ichisaur/cableBot/1-15 meeting notes.md

# Team Roles

## Team Leader
Yichen

## Treasurer
Alex

## Electrical
Yichen <br>
Alex

## CAD
Lukai<br>
Jordan<br>
Alex

## Manufacturing
Alex <br>
Literally Everyone

## Software
Qinjie<br>
Jordan<br>
Lukai

## Algorithms
?????

# Goals for End of Quarter
Design for <br>
Motor controllers Driver Modules <br>
Microcontroller Circuitry
<br>External Case Design
<br>Control Algorithm Prototype
