ichisaur/cableBot/BYOM-Group1/MatlabAnalysis/Current-Torque.jpg

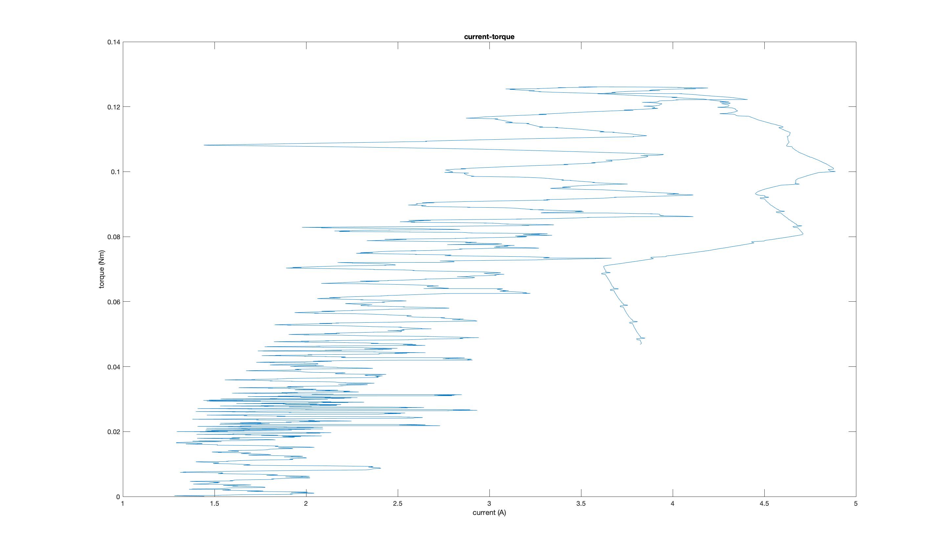
BYOM-Group1/MatlabAnalysis/Current-Torque.jpg
