ichisaur/cableBot/BYOM-Group1/MatlabAnalysis/Motor Current.jpg

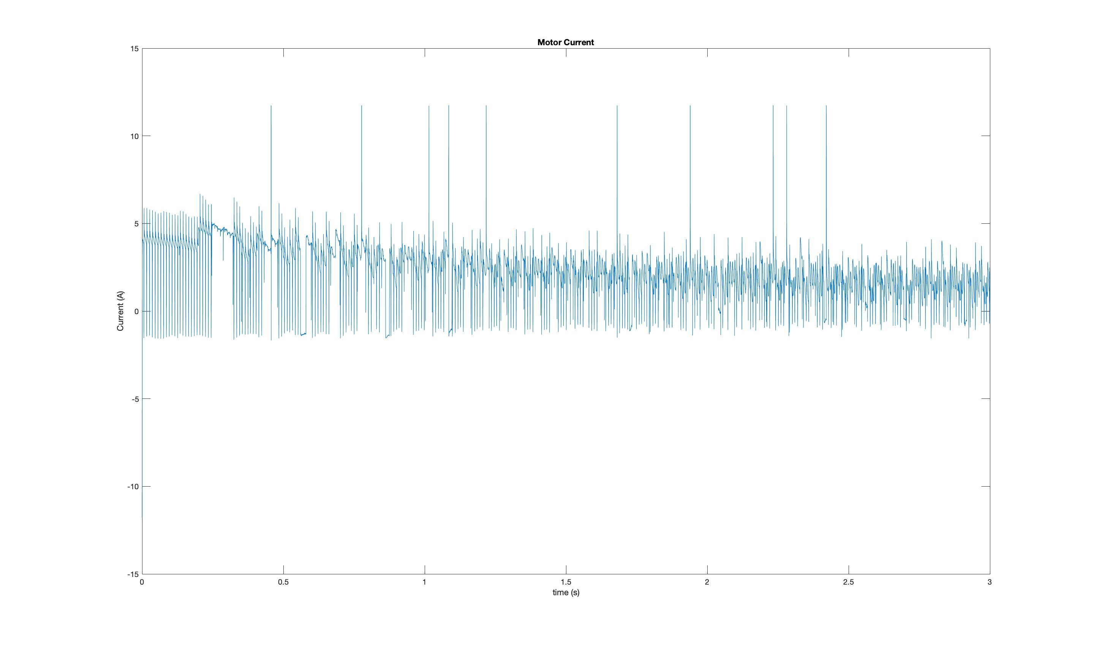
BYOM-Group1/MatlabAnalysis/Motor Current.jpg
