ichisaur/cableBot/BYOM-Group1/MatlabAnalysis/Motor Position.jpg

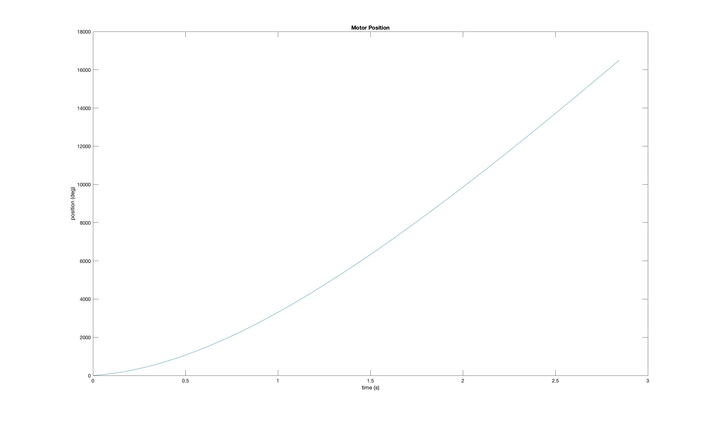
BYOM-Group1/MatlabAnalysis/Motor Position.jpg
