ichisaur/cableBot/BYOM-Group1/MatlabAnalysis/Motor speed.jpg

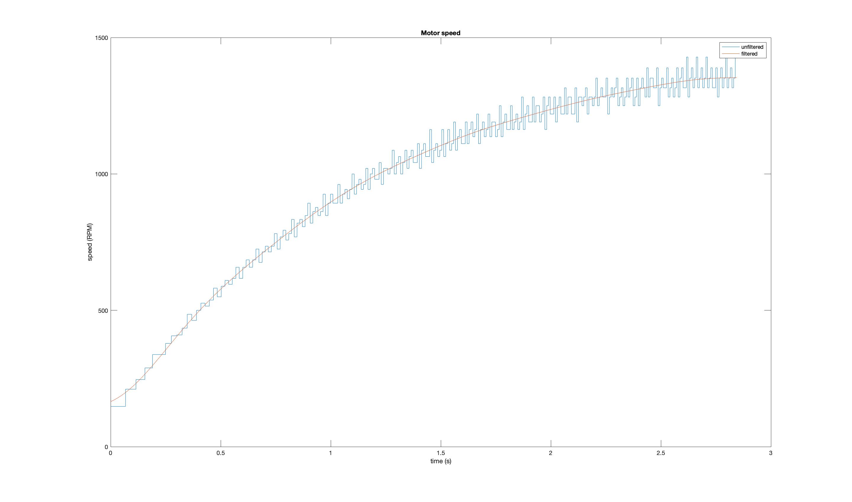
BYOM-Group1/MatlabAnalysis/Motor speed.jpg
