ichisaur/cableBot/BYOM-Group1/MatlabAnalysis/RMS Motor Current.jpg

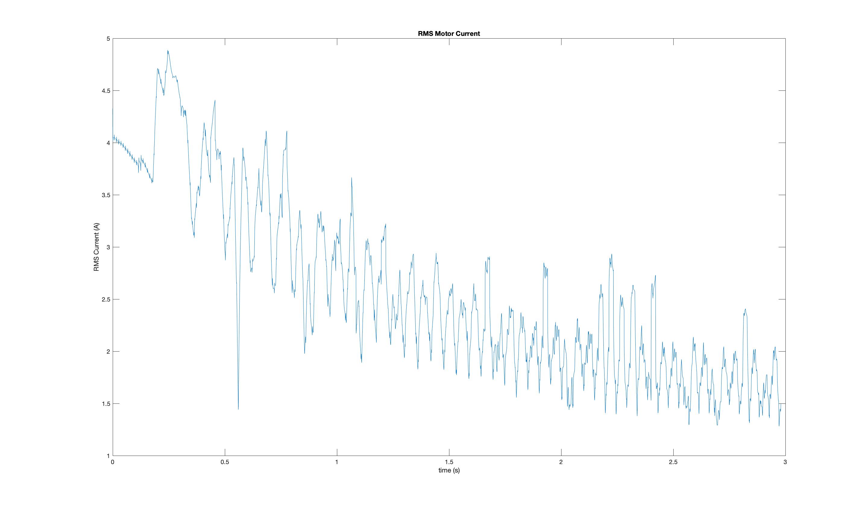
BYOM-Group1/MatlabAnalysis/RMS Motor Current.jpg
