ichisaur/cableBot/BYOM-Group1/MatlabAnalysis/Speed-Torque.jpg

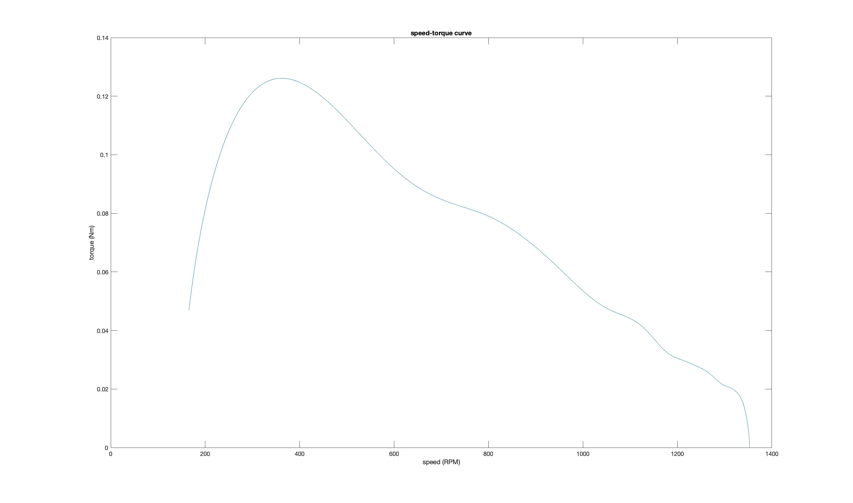
BYOM-Group1/MatlabAnalysis/Speed-Torque.jpg
