ichisaur/cableBot/Eagle Boards/Main Board/Electrical BOM.txt

Partlist exported from C:/Users/ichis/Documents/Development Area/cableBot/Eagle Boards/Main Board/main.sch at 3/15/2019 1:38 AM

Qty Value               Device              Package                  Parts                                                                                                                 Description                                                                                                      AVAILABILITY DESCRIPTION                                                                                  DIGI-KEY_PART_NUMBER DIGI-KEY_PURCHASE_URL                                                                                                                                                                    MANUFACTURER_PART_NUMBER MF      MP                  MPN     OC_FARNELL OC_NEWARK PACKAGE                         PRICE VENDOR                 
10  0.1uF               C-USC0805           C0805                    C5, C6, C7, C8, C9, C10, C11, C12, C13, C15                                                                           CAPACITOR, American symbol                                                                                                                                                                                                                                                                                                                                                                                                                                                                                                                                                              
25  10k                 R-US_R0603          R0603                    R1, R5, R6, R7, R8, R9, R10, R11, R12, R13, R14, R15, R16, R17, R18, R19, R20, R21, R22, R23, R24, R25, R26, R27, R28 RESISTOR, American symbol                                                                                                                                                                                                                                                                                                                                                                                                                                                                                                                                                               
2   10pF                C-USC0805           C0805                    C3, C4                                                                                                                CAPACITOR, American symbol                                                                                                                                                                                                                                                                                                                                                                                                                                                                                                                                                              
1   10uF                C-USC0805           C0805                    C14                                                                                                                   CAPACITOR, American symbol                                                                                                                                                                                                                                                                                                                                                                                                                                                                                                                                                              
4   1uF                 C-USC0805           C0805                    C16, C17, C18, C19                                                                                                    CAPACITOR, American symbol                                                                                                                                                                                                                                                                                                                                                                                                                                                                                                                                                              
2   24pF                C-USC0805           C0805                    C1, C2                                                                                                                CAPACITOR, American symbol                                                                                                                                                                                                                                                                                                                                                                                                                                                                                                                                                              
1   330                 R-US_R0805          R0805                    R2                                                                                                                    RESISTOR, American symbol                                                                                                                                                                                                                                                                                                                                                                                                                                                                                                                                                               
1   AB26TRB-32.768KHZ-T AB26TRB-32.768KHZ-T XTAL_AB26TRB-32.768KHZ-T XTAL1                                                                                                                 AB26TRB Series 32.768 kHz ±20 ppm 12.5 pF -40 to +85°C Cylindrical Watch Crystal                                               AB26TRB Series 32.768 kHz ±20 ppm 12.5 pF -40 to +85°C Cylindrical Watch Crystal            535-9033-1-ND        https://www.digikey.com/product-detail/en/abracon-llc/AB26TRB-32.768KHZ-T/535-9033-1-ND/675581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                                                       Abracon AB26TRB-32.768KHZ-T                              Cylindrical Can Radial  Abracon                              
1   ABM3-16.000MHZ-B2-T ABM3-16.000MHZ-B2-T XTAL500X320X130N         Y1                                                                                                                    Crystals 12MHz 18pF 30ppm -40C +85C                                                                                            Crystal 16MHz Ø·Â¢Ø¢Â±20ppm _Tol_ Ø·Â¢Ø¢Â±50ppm _Stability_ 18pF FUND 50Ohm 2-Pin CSMD T/R  535-9103-1-ND        https://www.digikey.com/product-detail/en/abracon-llc/ABM3-16.000MHZ-B2-T/535-9103-1-ND/675620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                                                       Abracon ABM3-16.000MHZ-B2-T                              SMD-2 Abracon                                                
12  BSS138SOT-23-3L-L   BSS138SOT-23-3L-L   SOT-23-3L-L              U3, U4, U5, U6, U7, U8, U9, U10, U11, U12, U13, U14                                                                   MOSFET, Level Shifting                                                                                                                                                                                                                                                                                                                                                                                                                                         BSS138                                                                                            Fairchild Semiconductor
1   FT232RL-TUBE        FT232RL-TUBE        SSOP28-LD                IC2                                                                                                                   USB to UART Chip                                                                                                                               USB-to-UART 1-CH 256byte FIFO 5V 28-Pin SSOP Tube                                           768-1306-ND          https://www.digikey.com/product-detail/en/ftdi-future-technology-devices-international-ltd/FT232RL-TUBE/768-1306-ND/4006920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                          FTDI,   FT232RL-TUBE                     SSOP-28 FTDI                                                 
1   Green               LEDCHIP-LED0805     CHIP-LED0805             LED1                                                                                                                  LED                                                                                                                                                                                                                                                                                                                                                                                                                                                                                                                                                                                     
1   JS202011SCQN        JS202011SCQN        SW_JS202011SCQN          S1                                                                                                                    JS Series DPDT On-On Gull Wing Surface Mount Subminiature Slide Switch                                           Unavailable   JS Series DPDT On-On Gull Wing Surface Mount Subminiature Slide Switch                                                                                                                                                                                                                                                             C&K     JS202011SCQN                                     None                            None                         
1   OMRON SWITCH        MOM_SWITCH          SWITCH                   B1                                                                                                                    Momentary Switch                                                                                                                                                                                                                                                                                                                                                                                                                                                                                                                                                                        
1   PROG                CONN_07             1X07                     J3                                                                                                                    Multi connection point. Often used as Generic Header-pin footprint for 0.1 inch spaced/style header connections                                                                                                                                                                                                                                                                                                                                                                                                                                                                         
1   PROG_RST            CONN_01             1X01                     J4                                                                                                                    Single connection point. Often used as Generic Header-pin footprint for 0.1 inch spaced/style header connections                                                                                                                                                                                                                                                                                                                                                                                                                                                                        
1   AZ1117EH-3.3        AZ1117EH-3.3        SOT223                   IC1                                                                                                                   800mA and 1A Low Dropout (LDO) Positive Regulator 3.3v                                                                                                                                                                                                                                                                                                                                                                                                                                                                                         
1   AZ1117EH-5.0        AZ1117EH-5.0        SOT223                   IC3                                                                                                                   800mA and 1A Low Dropout (LDO) Positive Regulator 5.0v                                                                                                                                                                                                                                                                                                                                                                                                                                                                                        
3   ST26C31BTR          ST26C31BTR          TSSOP16                  CR1, CR2, CR3                                                                                                                                                                                                                                                                                                                                                                                                                                                                                                                                                  ST26C31BTR                                                                                                              STMicroelectronics     
1   TM4C123GH6PMIPM64-L TM4C123GH6PMIPM64-L PM64-L                   U1                                                                                                                                                                                                                                                                                                                                                                                                                                                                                                                                                             TM4C123GH6PMI                                                                                                           Texas Instruments      
1   ZX62MICROUSB        ZX62MICROUSB        ZX62-AB-5PA(11)          U$1
