ichisaur/cableBot/Eagle Boards/Main Board/main.brd

## EAGLE design Eagle Boards/Main Board/main.brd (2019-05-23)

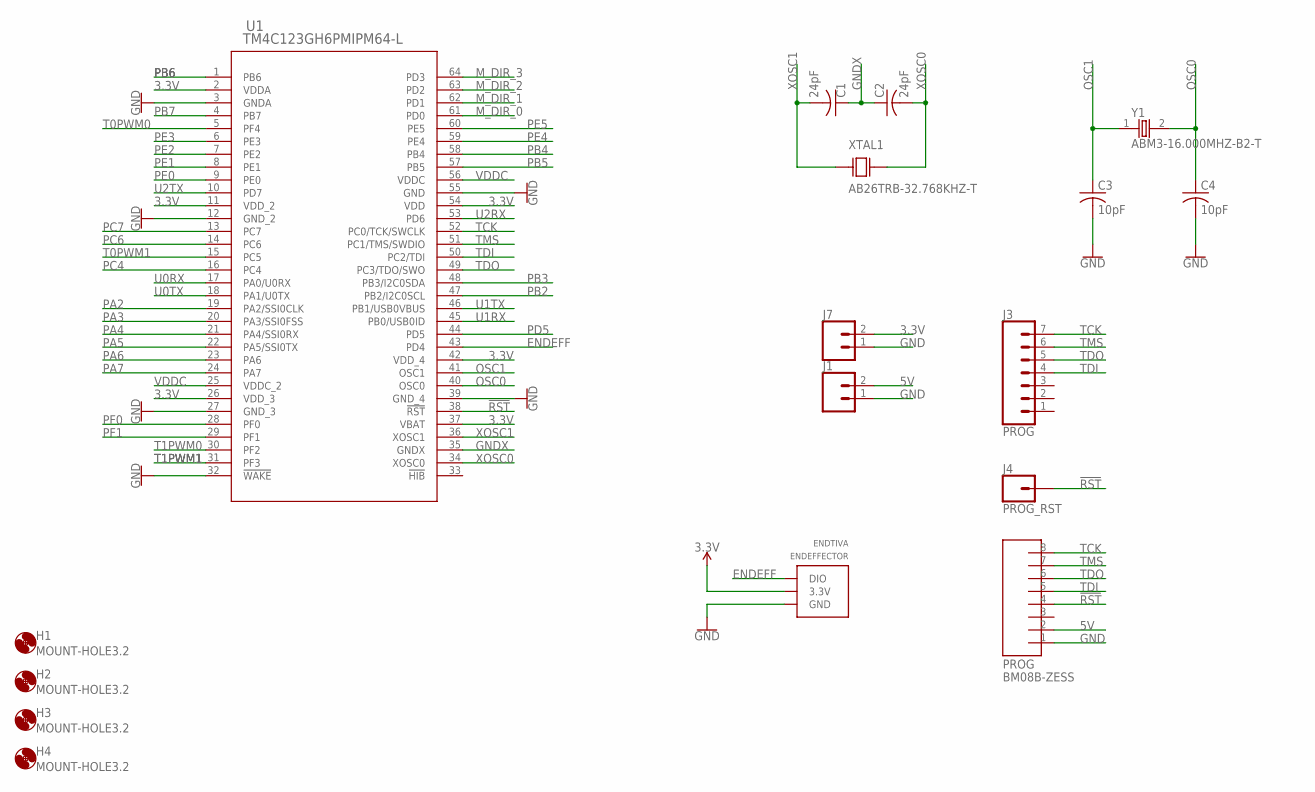
[picture p8: schematic main.sch, sheet 1, TIVA + IC]

Parts:
C1, C2: 24pF; C0805
C3, C4: 10pF; C0805
ENDEFFECTOR: ENDTIVA
H1, H2, H3, H4: MOUNT-HOLE3.2; 3,2
J1, J7: CONN_02; 1X02
J3: PROG; 1X07
J4: PROG_RST; 1X01
PROG: BM08B-ZESS
U1: TM4C123GH6PMIPM64-L; PM64-L
XTAL1: AB26TRB-32.768KHZ-T; XTAL_AB26TRB-32.768KHZ-T
Y1: ABM3-16.000MHZ-B2-T; XTAL500X320X130N

Connections:
3.3V: ENDEFFECTOR.3.3V, J7.2, U1.2 (VDDA), U1.11 (VDD_2), U1.26 (VDD_3), U1.37 (VBAT), U1.42 (VDD_4), U1.54 (VDD); also elsewhere on the board
5V: J1.2, PROG.2; also elsewhere on the board
!RST: J4.1, PROG.4, U1.38 (!RST); also elsewhere on the board
ENDEFF: ENDEFFECTOR.DIO, U1.43 (PD4)
GND: C3.2, C4.2, ENDEFFECTOR.GND, J1.1, J7.1, PROG.1, U1.3 (GNDA), U1.12 (GND_2), U1.27 (GND_3), U1.32 (!WAKE), U1.39 (GND_4), U1.55 (GND); also elsewhere on the board
GNDX: C1.1, C2.1, U1.35 (GNDX)
M_DIR_0: U1.61 (PD0); also elsewhere on the board
M_DIR_1: U1.62 (PD1); also elsewhere on the board
M_DIR_2: U1.63 (PD2); also elsewhere on the board
M_DIR_3: U1.64 (PD3); also elsewhere on the board
OSC0: C4.1, U1.40 (OSC0), Y1.2
OSC1: C3.1, U1.41 (OSC1), Y1.1
PA2: U1.19 (PA2/SSI0CLK)
PA3: U1.20 (PA3/SSI0FSS)
PA4: U1.21 (PA4/SSI0RX)
PA5: U1.22 (PA5/SSI0TX)
PA6: U1.23 (PA6)
PA7: U1.24 (PA7)
PB2: U1.47 (PB2/I2C0SCL)
PB3: U1.48 (PB3/I2C0SDA)
PB4: U1.58 (PB4)
PB5: U1.57 (PB5)
PB6: U1.1 (PB6)
PB7: U1.4 (PB7)
PC4: U1.16 (PC4)
PC6: U1.14 (PC6)
PC7: U1.13 (PC7)
PD5: U1.44 (PD5)
PE0: U1.9 (PE0)
PE1: U1.8 (PE1)
PE2: U1.7 (PE2)
PE3: U1.6 (PE3)
PE4: U1.59 (PE4)
PE5: U1.60 (PE5)
PF0: U1.28 (PF0)
PF1: U1.29 (PF1)
T0PWM0: U1.5 (PF4); also elsewhere on the board
T0PWM1: U1.15 (PC5); also elsewhere on the board
T1PWM0: U1.30 (PF2); also elsewhere on the board
T1PWM1: U1.31 (PF3); also elsewhere on the board
TCK: J3.7, PROG.8, U1.52 (PC0/TCK/SWCLK)
TDI: J3.4, PROG.5, U1.50 (PC2/TDI)
TDO: J3.5, PROG.6, U1.49 (PC3/TDO/SWO)
TMS: J3.6, PROG.7, U1.51 (PC1/TMS/SWDIO)
U0RX: U1.17 (PA0/U0RX); also elsewhere on the board
U0TX: U1.18 (PA1/U0TX); also elsewhere on the board
U1RX: U1.45 (PB0/USB0ID); also elsewhere on the board
U1TX: U1.46 (PB1/USB0VBUS); also elsewhere on the board
U2RX: U1.53 (PD6)
U2TX: U1.10 (PD7)
VDDC: U1.25 (VDDC_2), U1.56 (VDDC); also elsewhere on the board
XOSC0: C2.2, U1.34 (XOSC0), XTAL1.2
XOSC1: C1.2, U1.36 (XOSC1), XTAL1.1

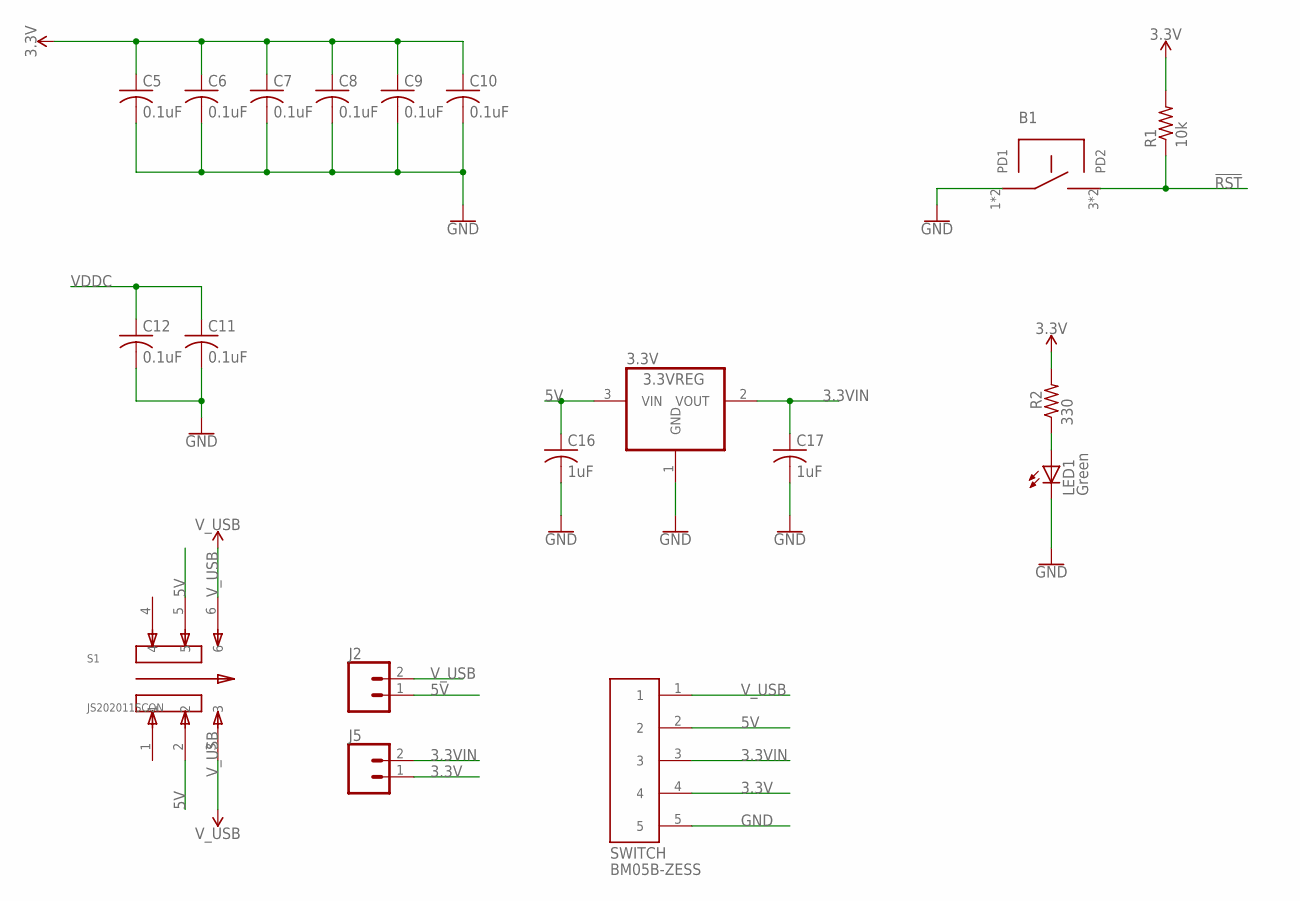
[picture p9: schematic main.sch, sheet 2, POWER]

Parts:
3.3V: 3.3VREG; SOT223
B1: B3S-1000; SWITCH
C5, C6, C7, C8, C9, C10, C11, C12: 0.1uF; C0805
C16, C17: 1uF; C0805
J2, J5: CONN_02; 1X02
LED1: Green; CHIP-LED0805
R1: 10k; R0603
R2: 330; R0805
S1: JS202011SCQN; SW_JS202011SCQN
SWITCH: BM05B-ZESS

Connections:
3.3V: C5.1, C6.1, C7.1, C8.1, C9.1, C10.1, J5.1, R1.2, R2.2, SWITCH.4; also elsewhere on the board
3.3VIN: 3.3V.2 (VOUT), C17.1, J5.2, SWITCH.3; also elsewhere on the board
5V: 3.3V.3 (VIN), C16.1, J2.1, S1.2, S1.5, SWITCH.2; also elsewhere on the board
!RST: B1.3 (PD2), B1.4 (PD2), R1.1; also elsewhere on the board
GND: 3.3V.1 (GND), B1.1 (PD1), B1.2 (PD1), C5.2, C6.2, C7.2, C8.2, C9.2, C10.2, C11.2, C12.2, C16.2, C17.2, LED1.C, SWITCH.5; also elsewhere on the board
unnamed: LED1.A, R2.1
VDDC: C11.1, C12.1; also elsewhere on the board
V_USB: J2.2, S1.3, S1.6, SWITCH.1; also elsewhere on the board

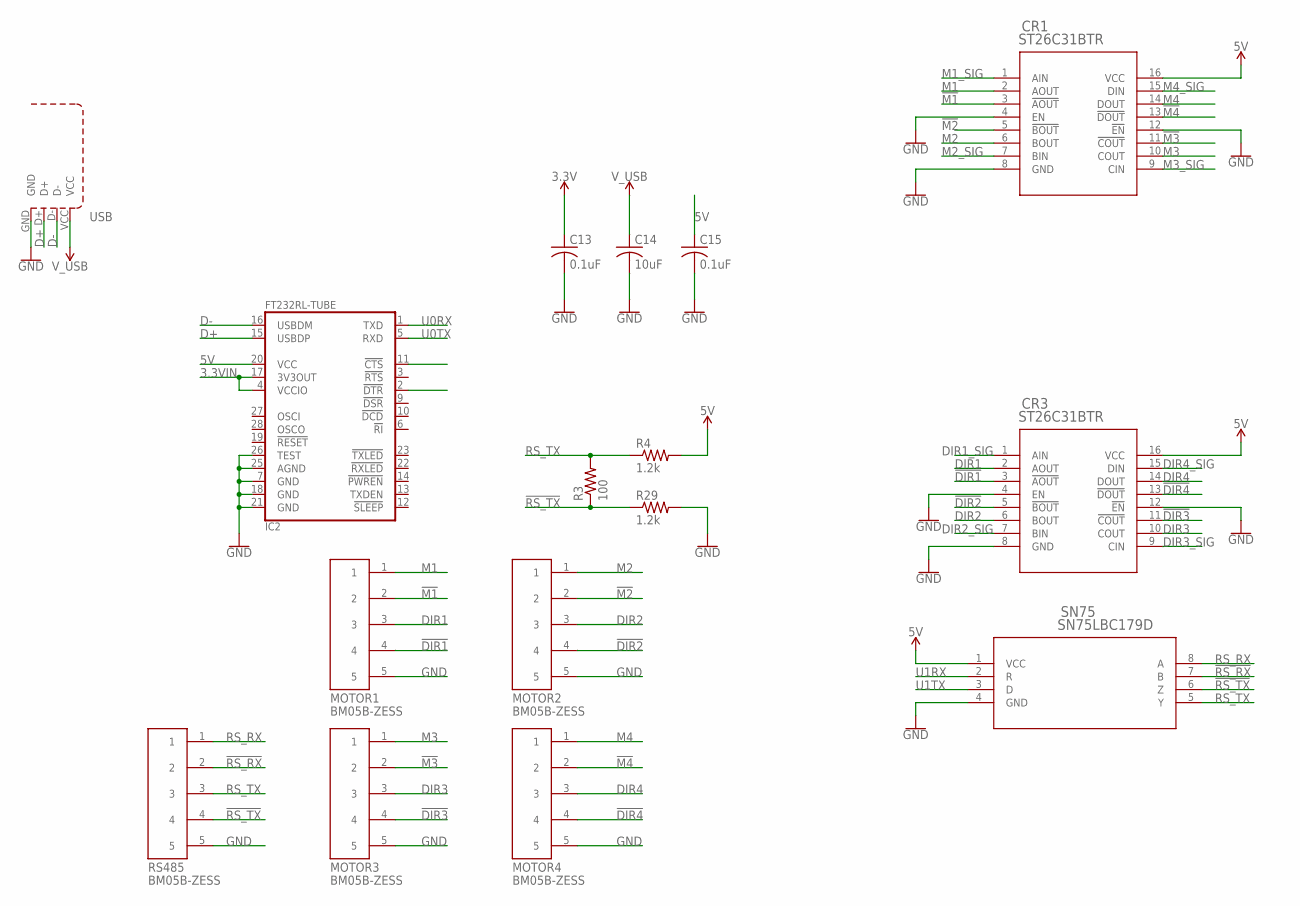
[picture p10: schematic main.sch, sheet 3, COMMUNICATION]

Parts:
C13, C15: 0.1uF; C0805
C14: 10uF; C0805
CR1, CR3: ST26C31BTR; TSSOP16
IC2: FT232RL-TUBE; SSOP28-LD
MOTOR1, MOTOR2, MOTOR3, MOTOR4: BM05B-ZESS
R3: 100; R0805
R4, R29: 1.2k; R0805
RS485: BM05B-ZESS
SN75: SN75LBC179D; D8
USB: ZX62MICROUSB; ZX62-AB-5PA(11)

Connections:
3.3V: C13.1; also elsewhere on the board
3.3VIN: IC2.4 (VCCIO), IC2.17 (3V3OUT); also elsewhere on the board
5V: C15.1, CR1.16 (VCC), CR3.16 (VCC), IC2.20 (VCC), R4.2, SN75.1 (VCC); also elsewhere on the board
!DIR1: CR3.3 (!AOUT), MOTOR1.4
!DIR2: CR3.5 (!BOUT), MOTOR2.4
!DIR3: CR3.11 (!COUT), MOTOR3.4
!DIR4: CR3.13 (!DOUT), MOTOR4.4
!M1: CR1.3 (!AOUT), MOTOR1.2
!M2: CR1.5 (!BOUT), MOTOR2.2
!M3: CR1.11 (!COUT), MOTOR3.2
!M4: CR1.13 (!DOUT), MOTOR4.2
!RS_RX: RS485.2, SN75.7 (B)
!RS_TX: R3.1, R29.1, RS485.4, SN75.6 (Z)
D+: IC2.15 (USBDP), USB.D+
D-: IC2.16 (USBDM), USB.D-
DIR1: CR3.2 (AOUT), MOTOR1.3
DIR1_SIG: CR3.1 (AIN); also elsewhere on the board
DIR2: CR3.6 (BOUT), MOTOR2.3
DIR2_SIG: CR3.7 (BIN); also elsewhere on the board
DIR3: CR3.10 (COUT), MOTOR3.3
DIR3_SIG: CR3.9 (CIN); also elsewhere on the board
DIR4: CR3.14 (DOUT), MOTOR4.3
DIR4_SIG: CR3.15 (DIN); also elsewhere on the board
GND: C13.2, C14.2, C15.2, CR1.4 (EN), CR1.8 (GND), CR1.12 (!EN), CR3.4 (EN), CR3.8 (GND), CR3.12 (!EN), IC2.7 (GND), IC2.18 (GND), IC2.21 (GND), IC2.25 (AGND), IC2.26 (TEST), MOTOR1.5, MOTOR2.5, MOTOR3.5, MOTOR4.5, R29.2, RS485.5, SN75.4 (GND), USB.GND; also elsewhere on the board
M1: CR1.2 (AOUT), MOTOR1.1
M1_SIG: CR1.1 (AIN); also elsewhere on the board
M2: CR1.6 (BOUT), MOTOR2.1
M2_SIG: CR1.7 (BIN); also elsewhere on the board
M3: CR1.10 (COUT), MOTOR3.1
M3_SIG: CR1.9 (CIN); also elsewhere on the board
M4: CR1.14 (DOUT), MOTOR4.1
M4_SIG: CR1.15 (DIN); also elsewhere on the board
RS_RX: RS485.1, SN75.8 (A)
RS_TX: R3.2, R4.1, RS485.3, SN75.5 (Y)
U0RX: IC2.1 (TXD); also elsewhere on the board
U0TX: IC2.5 (RXD); also elsewhere on the board
U1RX: SN75.2 (R); also elsewhere on the board
U1TX: SN75.3 (D); also elsewhere on the board
V_USB: C14.1, USB.VCC; also elsewhere on the board

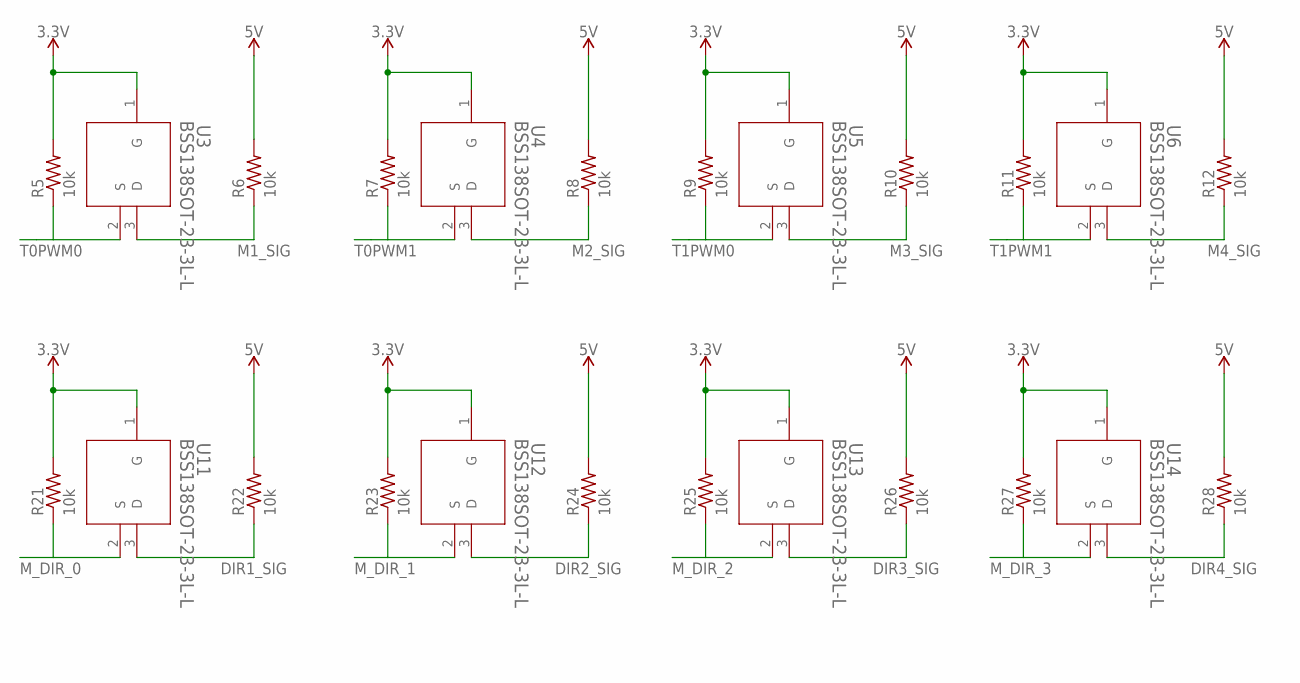
[picture p11: schematic main.sch, sheet 4]

Parts:
R5, R6, R7, R8, R9, R10, R11, R12, R21, R22, R23, R24, R25, R26, R27, R28: 10k; R0603
U3, U4, U5, U6, U11, U12, U13, U14: BSS138SOT-23-3L-L; SOT-23-3L-L

Connections:
3.3V: R5.2, R7.2, R9.2, R11.2, R21.2, R23.2, R25.2, R27.2, U3.1 (G), U4.1 (G), U5.1 (G), U6.1 (G), U11.1 (G), U12.1 (G), U13.1 (G), U14.1 (G); also elsewhere on the board
5V: R6.2, R8.2, R10.2, R12.2, R22.2, R24.2, R26.2, R28.2; also elsewhere on the board
DIR1_SIG: R22.1, U11.3 (D); also elsewhere on the board
DIR2_SIG: R24.1, U12.3 (D); also elsewhere on the board
DIR3_SIG: R26.1, U13.3 (D); also elsewhere on the board
DIR4_SIG: R28.1, U14.3 (D); also elsewhere on the board
M1_SIG: R6.1, U3.3 (D); also elsewhere on the board
M2_SIG: R8.1, U4.3 (D); also elsewhere on the board
M3_SIG: R10.1, U5.3 (D); also elsewhere on the board
M4_SIG: R12.1, U6.3 (D); also elsewhere on the board
M_DIR_0: R21.1, U11.2 (S); also elsewhere on the board
M_DIR_1: R23.1, U12.2 (S); also elsewhere on the board
M_DIR_2: R25.1, U13.2 (S); also elsewhere on the board
M_DIR_3: R27.1, U14.2 (S); also elsewhere on the board
T0PWM0: R5.1, U3.2 (S); also elsewhere on the board
T0PWM1: R7.1, U4.2 (S); also elsewhere on the board
T1PWM0: R9.1, U5.2 (S); also elsewhere on the board
T1PWM1: R11.1, U6.2 (S); also elsewhere on the board

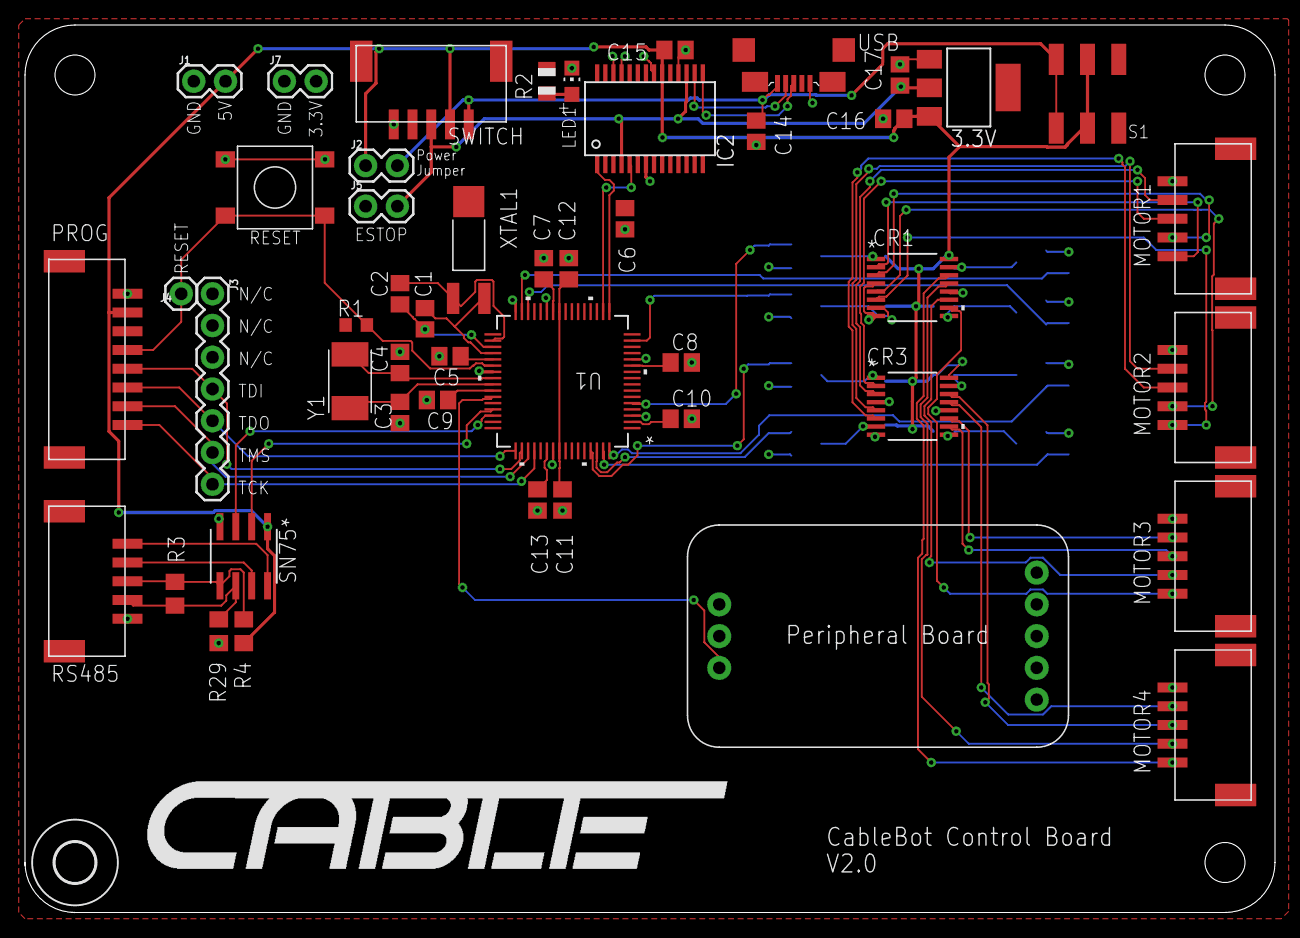
[picture p12: board main.brd from above]

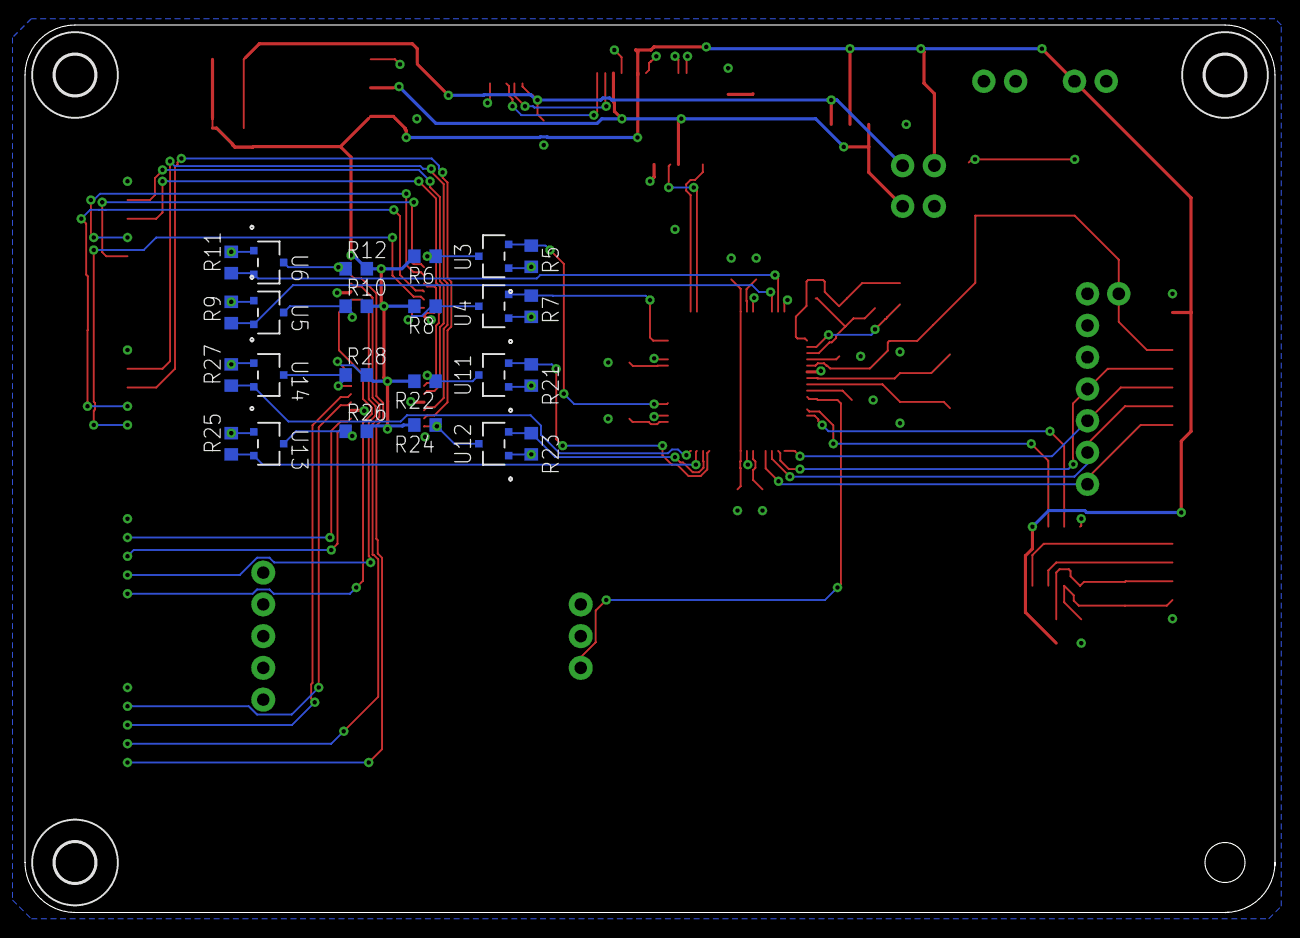
[picture p13: board main.brd from below]

Board: 2 copper layers, 100.0 x 71.0 mm, 76 parts (27 on the bottom side), 60 nets.
