ichisaur/cableBot/Eagle Boards/CableBotEndEffector/Tiva_Xbee.brd

## EAGLE design Eagle Boards/CableBotEndEffector/Tiva_Xbee.brd (2019-05-21)

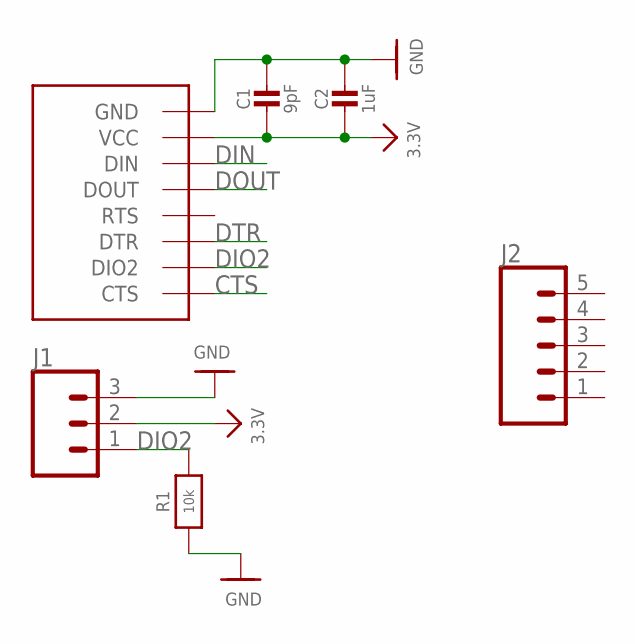
[picture p14: schematic Tiva_Xbee.sch]

Parts:
C1: 9pF; _0603
C2: 1uF; _0603
J1: CONN_03; 1X03
J2: CONN_05; 1X05
R1: 10k; _0603
U$1: XBEE3_DIO; XBEE3_MICRO

Connections:
3.3V: C1.2, C2.2, J1.2, U$1.VCC
CTS: U$1.CTS/DIO7 (CTS)
DIN: U$1.DIN/CONFIG/DIO14 (DIN)
DIO2: J1.1, R1.2, U$1.AD2/DIO2 (DIO2)
DOUT: U$1.DOUT/DIO13 (DOUT)
DTR: U$1.DTR/SLEEP_RQ/DIO8 (DTR)
GND: C1.1, C2.1, J1.3, R1.1, U$1.GND1 (GND), U$1.GND2 (GND), U$1.GND3 (GND), U$1.GND4 (GND), U$1.GND5 (GND), U$1.GND6 (GND)

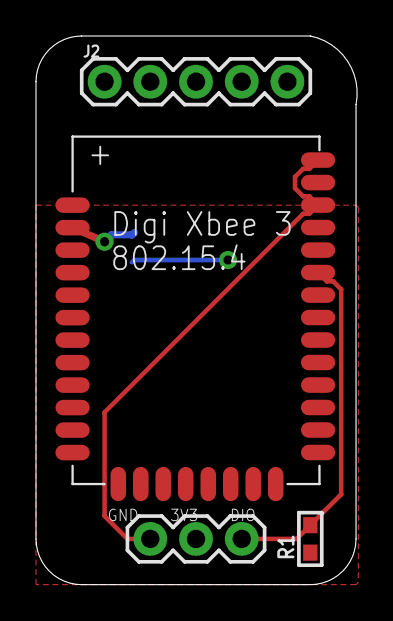
[picture p15: board Tiva_Xbee.brd from above]

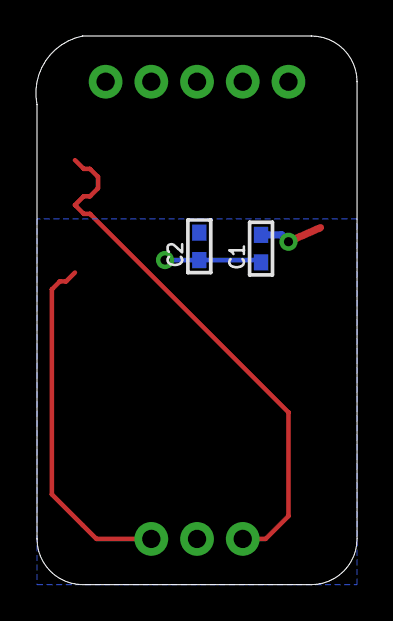
[picture p16: board Tiva_Xbee.brd from below]

Board: 2 copper layers, 17.8 x 30.5 mm, 6 parts (2 on the bottom side), 3 nets.
