ichisaur/cableBot/Eagle Boards/CableBotEndEffector/EndEffector.brd

## EAGLE design Eagle Boards/CableBotEndEffector/EndEffector.brd (2019-05-21)

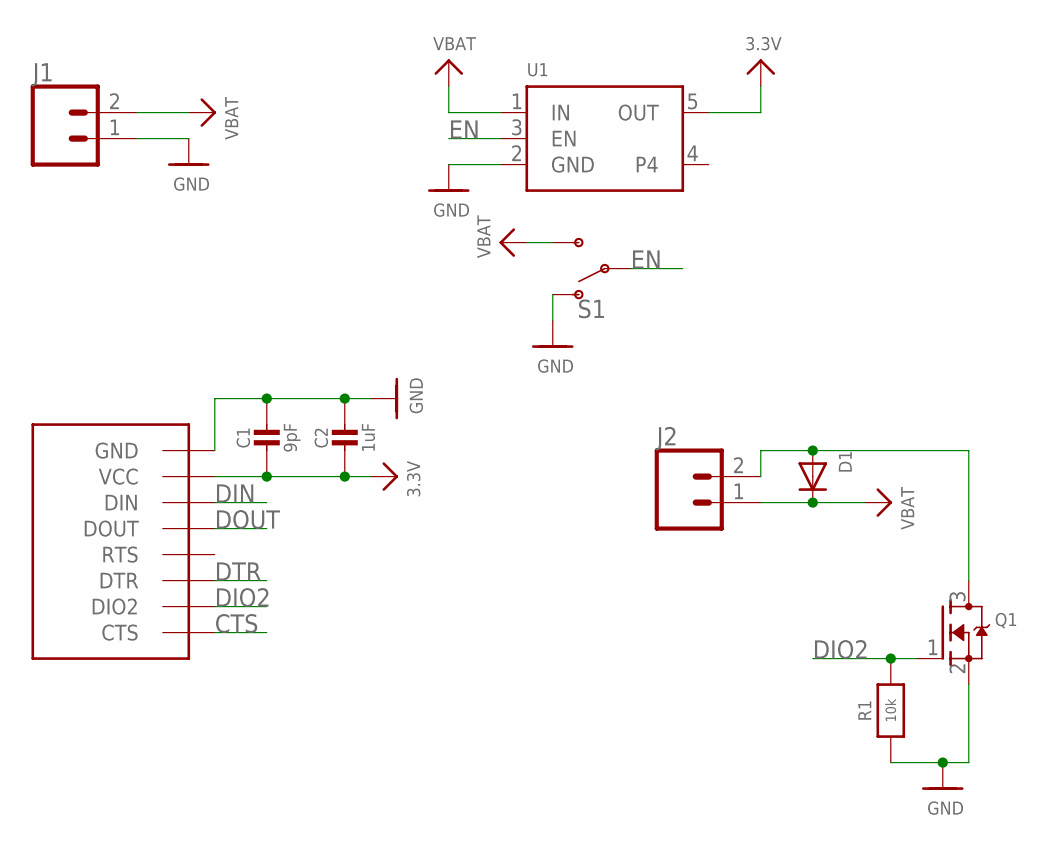
[picture p17: schematic EndEffector.sch]

Parts:
C1: 9pF; _0603
C2: 1uF; _0603
D1: DIODESOD-123; SOD-123
J1, J2: CONN_02; 1X02
Q1: MOSFET-NREFLOW; SOT23
R1: 10k; _0603
S1: SWITCH-SPDT-SMD-RIGHT-ANGLE; SWITCH_SPST_SMD_A
U1: VREG_SOT23-5; SOT23-5
U$1: XBEE3_DIO; XBEE3_MICRO

Connections:
3.3V: C1.2, C2.2, U1.5 (OUT), U$1.VCC
CTS: U$1.CTS/DIO7 (CTS)
DIN: U$1.DIN/CONFIG/DIO14 (DIN)
DIO2: Q1.1 (G), R1.2, U$1.AD2/DIO2 (DIO2)
DOUT: U$1.DOUT/DIO13 (DOUT)
DTR: U$1.DTR/SLEEP_RQ/DIO8 (DTR)
EN: S1.2, U1.3 (EN)
GND: C1.1, C2.1, J1.1, Q1.2 (S), R1.1, S1.1 (O), U1.2 (GND), U$1.GND1 (GND), U$1.GND2 (GND), U$1.GND3 (GND), U$1.GND4 (GND), U$1.GND5 (GND), U$1.GND6 (GND)
unnamed: D1.A, J2.2, Q1.3 (D)
VBAT: D1.C, J1.2, J2.1, S1.3 (S), U1.1 (IN)

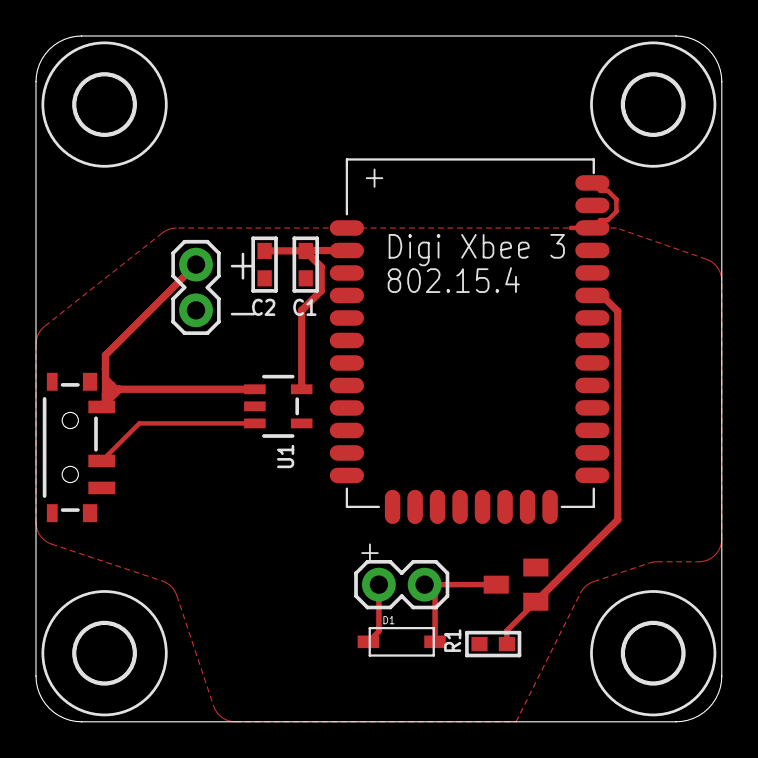
[picture p18: board EndEffector.brd from above]

Board: 2 copper layers, 38.1 x 38.1 mm, 14 parts (0 on the bottom side), 6 nets.

Other parts of the board:
U$13, U$14, U$15, U$16: 3,2
