ichisaur/cableBot/(commit log)

2019-01-21 pwm fix
2019-01-21 pwma and pwmc config cleanup
2019-01-21 inl pin config cleanup
2019-01-21 Revert "Update main.c"
    This reverts commit 892cddcca51696e9df26c6238c3d8480794f39d8.
    [main.c]
2019-01-21 Revert "Revert "Update main.c""
    This reverts commit c5488760f1286f888c1dd49c9b77d63d5c78e6b5.
    [main.c]
2019-01-21 Revert "Update main.c"
    This reverts commit b733a0eca9e7fd218a67054e3e62283663ca7c7e.
    [main.c]
2019-01-21 Revert "Update main.c"
    This reverts commit 1bdc145443f287e94f3abad9a679c0f99fe5012f.
    [main.c]
2019-01-21 PWM fixed
2019-01-21 interrupt testing
2019-01-21 working on interrupt
2019-01-21 Interrupt Troubleshooting
2019-01-22 Interrupts working
2019-01-22 ADC working (kinda)
2019-01-22 configure Timer3A
2019-01-22 timer interrupt
2019-01-23 Motor working
2019-01-23 some uart changes
2019-01-24 Data Collection Working
    [data01-23-191420.csv]
2019-01-24 Bit of processing
    [data0123191829.csv, data0123191829.xlsx]
2019-01-24 Data from Other Team
    [data0123191457.csv, data0123191829.xlsx, data0124172848.csv, sampleData from Other Team.csv]
2019-01-25 More correct data now
    [data0125131831.csv]
2019-01-25 Matlab Data Analysis
    [MotorData1.csv]
2019-03-14 Initial Commit Main Board
    [main.sch]
2019-04-10 finish most of board design prelim
    [Electrical BOM.csv, main.brd, main.sch]
2019-04-12 fix a few chips. add RS485 Hookup
    [main.brd, main.sch]
2019-04-24 Update eagle files
    [main.brd, main.sch]
2019-05-13 xbee boards
    [EndEffector.brd, EndEffector.sch, Tiva_Xbee.brd, Tiva_Xbee.sch]
2019-05-19 updated Xbee boards
    [EndEffector.brd, EndEffector.sch, Tiva_Xbee.brd]
2019-05-19 update xbee boards pt.2
    [EndEffector.brd, EndEffector.sch, Tiva_Xbee.brd, Tiva_Xbee.sch]
2019-05-19 xbee board update
    [EndEffector.brd, EndEffector.sch, Tiva_Xbee.brd, Tiva_Xbee.sch]
2019-05-21 clean up boards
    [Tiva_Xbee.brd, Tiva_Xbee.sch, main.brd, main.sch]
2019-05-21 new boards
    [main.brd, main.sch]
2019-05-21 final board prelim final design
    [main.brd, main.sch]
2019-05-23 Fix Firmware
    [main.brd, main.sch]
2019-05-23 Fix the not reading hwType bug. Now Echos hwType to buffer as well
    [main.c]
